MootSeeker/BekantX/README.md

# BekantX

## Documentation

- [Requirements specification](Docs/description.md)
- [System architecture](Docs/architecture.md)
- [Inter-controller SPI protocol](Docs/inter-controller-protocol.md)
- [IKEA BEKANT LIN protocol](Docs/bekant-lin-protocol.md)
