MootSeeker/BekantX/CAD/BekantX_Case.stl

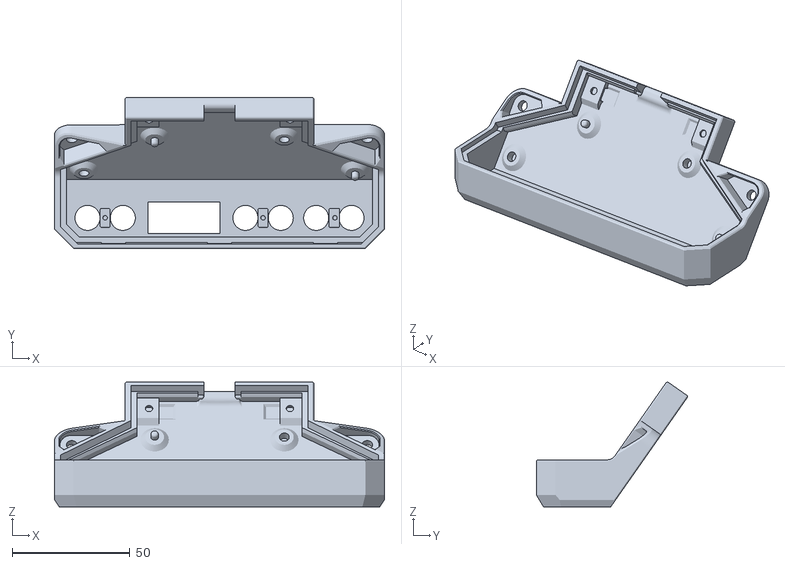
[picture p1: CAD file, 2026-04-22]
CAD/BekantX_Case.stl
140.0 x 64.1 x 53.0
