MootSeeker/BekantX/Pcb_HMI/PCB.step

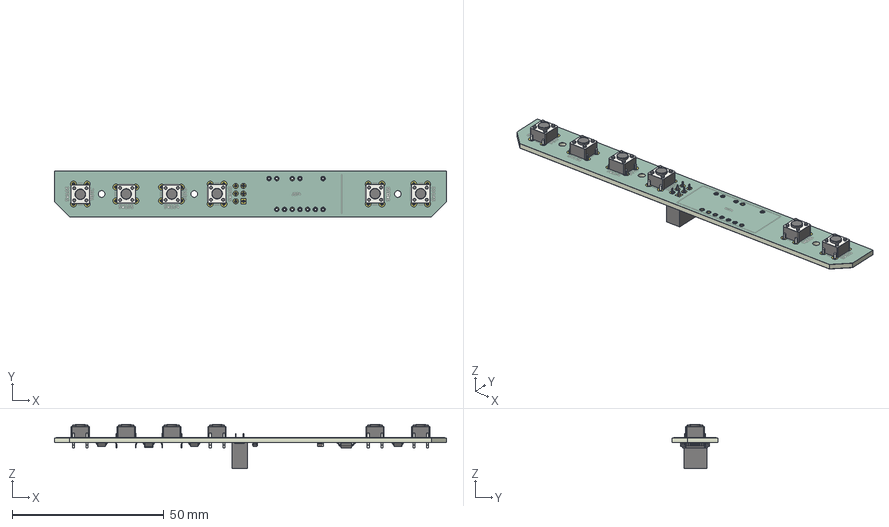
[picture p2: CAD file, 2026-04-20]
Pcb_HMI/PCB.step
129.0 x 15.0 x 14.5 mm
SW_PUSH_6mm x 6
PinSocket_2x03_P2.54mm_Vertical
SOT-23-5
R_0805_2012Metric
C_0805_2012Metric x 2
D_SOD-123 x 6
QSOP-24_3.9x8.7mm_P0.635mm
BekantX_HMI_copper
BekantX_HMI_silkscreen x 2
BekantX_HMI_soldermask x 2
BekantX_HMI_PCB
