MootSeeker/BekantX/CAD/BekantX_Lid.stl

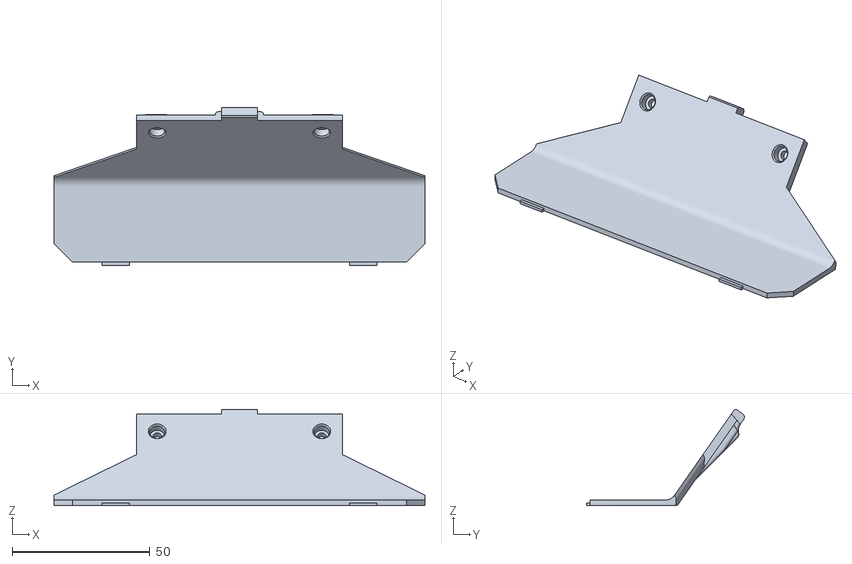
[picture p3: CAD file, 2026-04-22]
CAD/BekantX_Lid.stl
134.8 x 57.3 x 35.0
