MootSeeker/BekantX/Docs/ER-CON16HB-1.pdf

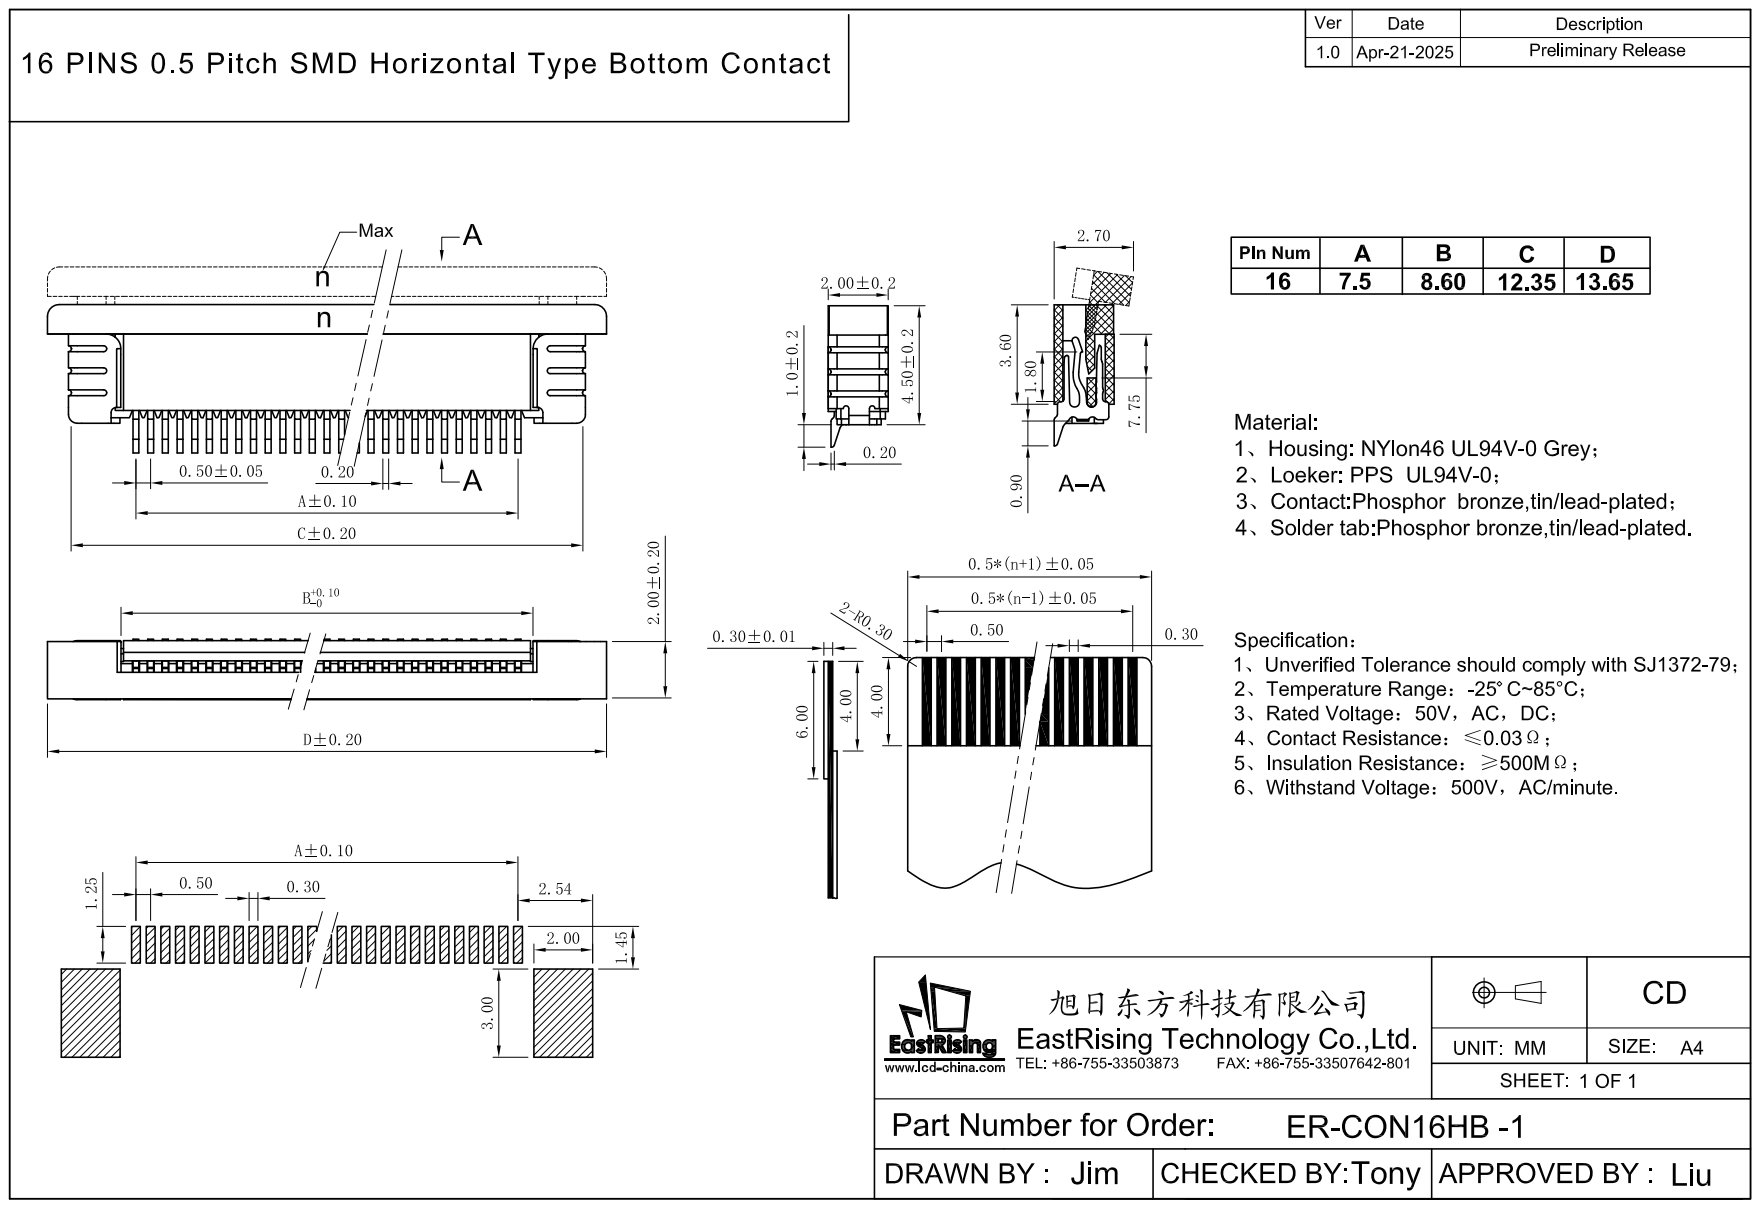
[picture p4: page 1]
