MootSeeker/BekantX/Pcb_HMI/BekantX_HMI.kicad_pcb

## KiCad design Pcb_HMI/BekantX_HMI.kicad_pcb (2026-04-20)

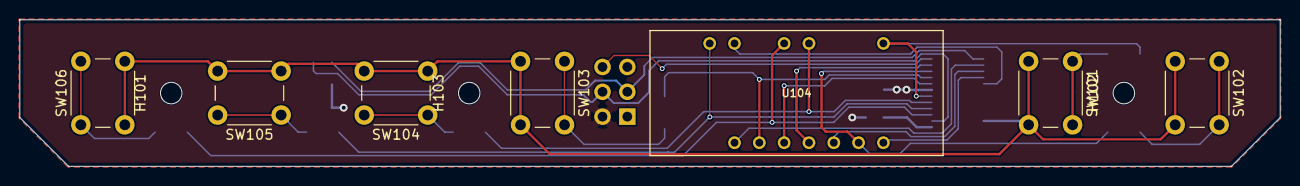
[picture p5: board BekantX_HMI.kicad_pcb from above]

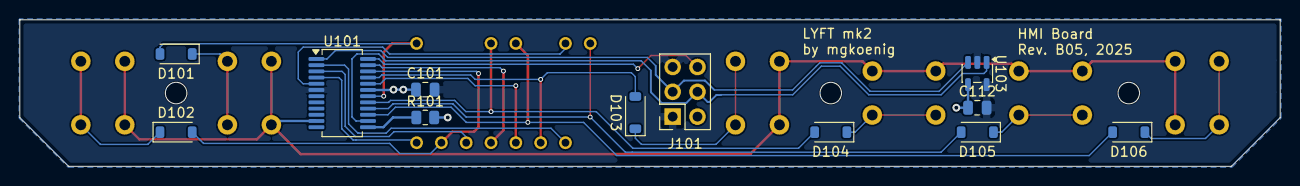
[picture p6: board BekantX_HMI.kicad_pcb from below]

Board: 2 copper layers, 129.0 x 15.0 mm, 22 parts (12 on the bottom side), 19 nets.

Parts:
C101: 10u; C_0805_2012Metric
C112: 100n; C_0805_2012Metric
D101, D102, D103, D104, D105, D106: 1N4148W; D_SOD-123
H101, H102, H103: MountingHole; MountingHole_2.2mm_M2
J101: Conn_HMI; PinSocket_2x03_P2.54mm_Vertical
R101: 13k; R_0805_2012Metric
SW101, SW102, SW103, SW104, SW105, SW106: SW_Omron_B3FS; SW_PUSH_6mm
U101: AS1115-BSST; QSOP-24_3.9x8.7mm_P0.635mm
U103: 24FC01T; SOT-23-5
U104: HDSP-433G

Connections:
+3V3: C101.1, C112.1, J101.2, R101.2, U101.19 (VDD), U103.4 (VCC)
GND: C101.2, C112.2, J101.1, J101.5, U101.6 (GND), U103.2 (GND), U103.5 (WP)
HMI_IRQ: J101.6, U101.24 (IRQ)
I2C_SCL: J101.4, U101.14 (SCL), U103.1 (SCL)
I2C_SDA: J101.3, U101.1 (SDA), U103.3 (SDA)
KEY_A: SW101.2, SW102.2, SW103.2, SW104.2, SW105.2, SW106.2, U101.11 (KEYA)
unnamed: D101.1 (K), SW101.1
unnamed: D102.1 (K), SW102.1
unnamed: D103.1 (K), SW103.1
unnamed: D104.1 (K), SW104.1
unnamed: D105.1 (K), SW105.1
unnamed: D106.1 (K), SW106.1
unnamed: R101.1, U101.13 (ISET)
SEG_A: D106.2 (A), U101.15 (SEGA)
SEG_B: D104.2 (A), U101.17 (SEGB)
SEG_DP: D102.2 (A), U101.22 (SEGDP)
SEG_E: D103.2 (A), U101.21 (SEGE)
SEG_F: D105.2 (A), U101.16 (SEGF)
SEG_G: D101.2 (A), U101.18 (SEGG)
