MootSeeker/BekantX/Firmware/ST/Bekanntx/Bekanntx.ioc

Mcu.UserName=STM32G0B1KBUx
PA0.Signal=SPI2_SCK
PA1.GPIO_Label=DISP_CS
PA1.Signal=GPIO_Output
PA10.Signal=SPI2_MOSI
PA13.Signal=SYS_SWDIO
PA14-BOOT0.Signal=SYS_SWCLK
PA15.Signal=S_TIM2_CH1_ETR
PA2.Signal=LPUART1_TX
PA3.Signal=LPUART1_RX
PA4.Signal=SPI1_NSS
PA5.Signal=SPI1_SCK
PA6.Signal=SPI1_MISO
PA7.Signal=SPI1_MOSI
PA8.GPIO_Label=DISP_DC
PA8.Signal=GPIO_Output
PA9.GPIO_Label=DISP_RES
PA9.Signal=GPIO_Output
PB0.GPIO_Label=BTN_2
PB0.Signal=GPXTI0
PB1.GPIO_Label=BTN_1
PB1.Signal=GPIO_Input
PB2.GPIO_Label=BTN_3
PB2.Signal=GPXTI2
PB3.Signal=S_TIM2_CH2
PB4.GPIO_Label=BTN_4
PB4.Signal=GPIO_Input
PB5.GPIO_Label=FSPI_INT
PB5.Signal=GPIO_Output
PB6.Signal=USART1_TX
PB7.Signal=USART1_RX
PB8.Signal=I2C1_SCL
PB9.Signal=I2C1_SDA
PC6.Signal=S_TIM2_CH3
