MootSeeker/BekantX/(commit log)

2026-04-16 Add documentation for BekantX project including LIN protocol, requirements, and inter-controller protocol
    - Introduced `bekant-lin-protocol.md` detailing the reverse-engineered LIN protocol for the IKEA BEKANT desk, covering bus characteristics, frame model, node map, runtime payload formats, and known commands/states.
    - Created `description.md` outlining the BekantX requirements specification, including purpose, scope, architectural requirements, functional requirements, safety and fault handling, and non-functional requirements.
    - Established `inter-controller-protocol.md` to define the message-level protocol between the primary and secondary controllers, detailing transport definition, fr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
2026-04-16 Add initial KiCad project files and .gitignore
    [BekantX.kicad_pcb, BekantX.kicad_sch]
2026-04-17 Add KiCad Project
    [BekantX.kicad_sch, Connector.kicad_sch, mastersheet.kicad_sch, microcontroller.kicad_sch, powerSupply.kicad_sch, wifi.kicad_sch]
2026-04-17 Update Schematic
    [Connector.kicad_sch, microcontroller.kicad_sch, powerSupply.kicad_sch, wifi.kicad_sch]
2026-04-18 Split Project into two PCBs. HMI PCB now has an OLED Display. Controller PCB is now steered by STM32 uC and uses ESP32-C3 as networking Module with inter CPU protocol.
    [BekantX.kicad_pcb, BekantX.kicad_sch, BekantX_HMI.kicad_pcb, BekantX_HMI.kicad_sch, Connector.kicad_sch, hmi.kicad_sch, mastersheet.kicad_sch, microcontroller.kicad_sch]
2026-04-19 work on HMI
    [BekantX_HMI.kicad_pcb, BekantX_HMI.kicad_sch]
2026-04-22 minor changes - added test points
    [hmi.kicad_sch, microcontroller.kicad_sch]
2026-04-22 Add some Test points
    [Connector.kicad_sch, powerSupply.kicad_sch, wifi.kicad_sch]
2026-04-22 Add Case
    [BekantX_Case.stl, BekantX_Lid.stl]
2026-04-22 Add Wi-Fi FTM example for ESP32-C3
    - Created CMakeLists.txt to define project structure.
    - Added main application code in ftm_main.c for FTM (Fine Timing Measurement) functionality.
    - Implemented command-line interface for Wi-Fi station and access point modes, including FTM initiator and responder commands.
    - Introduced configuration options in Kconfig.projbuild for enabling FTM report logging.
    - Added necessary JSON configuration files for Visual Studio Code integration.
    - Updated README.md with detailed usage instructions for the FTM example.
    - Included sdkconfig.defaults to enable Wi-Fi FTM support by default.
2026-04-25 Refactor BekantX application structure and integrate C++ components
    - Removed legacy FTM console dependencies from idf_component.yml.
    - Updated main application entry point to use CppWrapper instead of ftm_app.
    - Introduced bekantx_application component with Application class for application logic.
    - Created bekantx_core component to handle core functionalities and legacy console integration.
    - Added bekantx_drivers and bekantx_libs components for driver and library management.
    - Implemented utility functions in bekantx_utils for C++ integration.
    - Established a new command structure for Wi-Fi functionalities, including FTM commands.
    - Enhanced logging for better traceability during applicat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
2026-04-25 feat(led): add WS2812 RGB LED driver with breath animation
    - Add ws2812_transport (C/RMT backend, GPIO18, 10 MHz, GRB order)
    - Add LedDriver C++ class (pixel buffer, brightness scaling, Show/Clear)
    - Add LedAnimator C++ state machine (Blink, FadeIn/Out, FadeInOut, Breath)
    - Add LED_BREATH mode: cubic smooth-step 0->max->0, flicker-free at wrap
    - Add StatusIndicator mapping DeviceStatus to LED patterns
    - Boot pattern: yellow LED_BREATH, period 2 s, brightness 0-100
    - Wire LED subsystem into Application::Run() with 60 Hz tick loop
    - Update bekantx_drivers and bekantx_application CMakeLists
2026-04-28 feat: Implement WiFi Credential Store and Manager
    - Added WifiCredentialStore for managing WiFi credentials with NVS.
    - Implemented WifiManager to handle WiFi connections and provisioning.
    - Introduced captive portal HTML for user interaction during provisioning.
    - Created DNS hijack functionality to redirect DNS queries to the captive portal.
    - Added event handling for WiFi state changes and credential saving.
    - Enhanced user experience with status indicators and error handling in the portal.
    [WifiCredentialStore.cpp, WifiManager.cpp]
2026-04-30 feat: Add MQTT service for BekantX desk control
    - Introduced MQTT service to manage communication with Home Assistant.
    - Added configuration options for MQTT broker URI, device ID, and topics.
    - Implemented MQTT command handling, state publishing, and auto-discovery for Home Assistant.
    - Integrated deep sleep functionality with configurable wake GPIO.
    - Created necessary classes for handling MQTT credentials, commands, state, and discovery.
    - Updated Kconfig to include new MQTT and deep sleep options.
    - Added support for JSON command parsing and deduplication.
    - Implemented NVS storage for MQTT credentials.
2026-11-13 chore(pcb): Add board design settings to Controller KiCad project
2026-11-13 chore: Add project guidelines, skills, hooks and Freerouting pipeline (#1)
    * docs(vault): Add toolchain note for KiCad CLI/Python and build123d
    Document kicad-cli, KiCad-bundled Python (pcbnew, kicad-skip, kipy) and
    the build123d venv for enclosure CAD, and link it from the index.
    * chore: Add project guidelines, skills, hooks and Freerouting pipeline
    - CLAUDE.md with project context, guardrails and git rules
    - 14 skills, 4 read-only reviewer subagents, git guard and KiCad ERC/DRC hooks
    - tools/pcb/autoroute.py: DSN export, Freerouting, SES import, zone refill,
    measurement and parameter sweep, with starter profiles
    - pcb-design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
2026-11-13 feat(pcb): Merge HMI into controller schematic, add OLED and desk protection (#2)
    - Merge the HMI board into Pcb_Controller: six buttons on STM32 GPIO
    (BTN_1..6), EEPROM on I2C1, board-to-board connector removed.
    - Add 1.29" CH1115 OLED (ER-OLED1.29-2W, 16-pin FPC) with charge pump
    supply, IREF, and 4-wire SPI on SPI2; DISP_RES pull-down.
    - Desk input: fuse, TVS, reverse-polarity Schottky, LIN ESD diode
    (ASSUMPTION: desk voltage, LIN level and pinout not measured).
    - Replace XL1509 3.3 V stage with LMR51610 (synchronous, 4-65 V).
    - Single +3V3 rail (was two unconnected nets); LPUART crossed to ESP UART0.
    - LIN_TX pull-up R45; CS_N pull-up on primary rail; FSPI_INT on PB5.
    - SPI nets re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
    [Connector.kicad_sch, hmi.kicad_sch, microcontroller.kicad_sch, powerSupply.kicad_sch, wifi.kicad_sch]
